MrAlvin/RAMPS-1.4.4/Schematics/RAMPS-1.4.4-C-pins.jpg

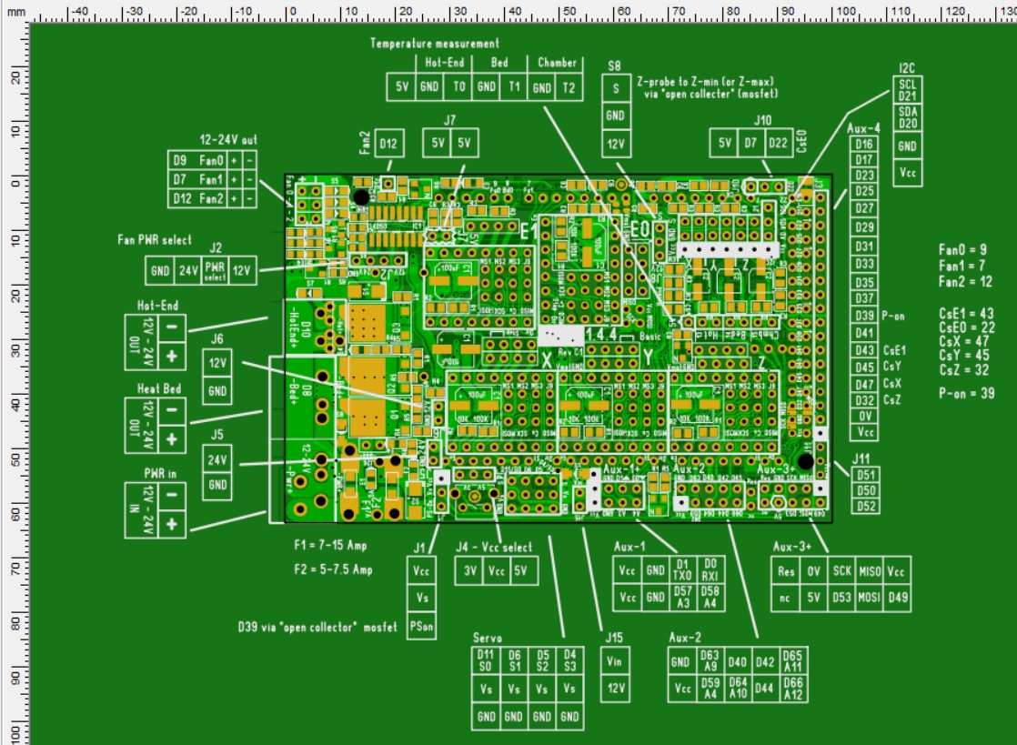
Schematics/RAMPS-1.4.4-C-pins.jpg
