MrAlvin/RAMPS-1.4.4/README.md

# RAMPS_1.4.4
An Arduino Shield for 3D printers

Documentation at: https://reprap.org/wiki/RAMPS_1.4.4<br>
Forum discussion at: todo<br>
Firmware development at: todo
