MrAlvin/RAMPS-1.4.4/Schematics/RAMPS_1.4.4-schematic-color.pdf

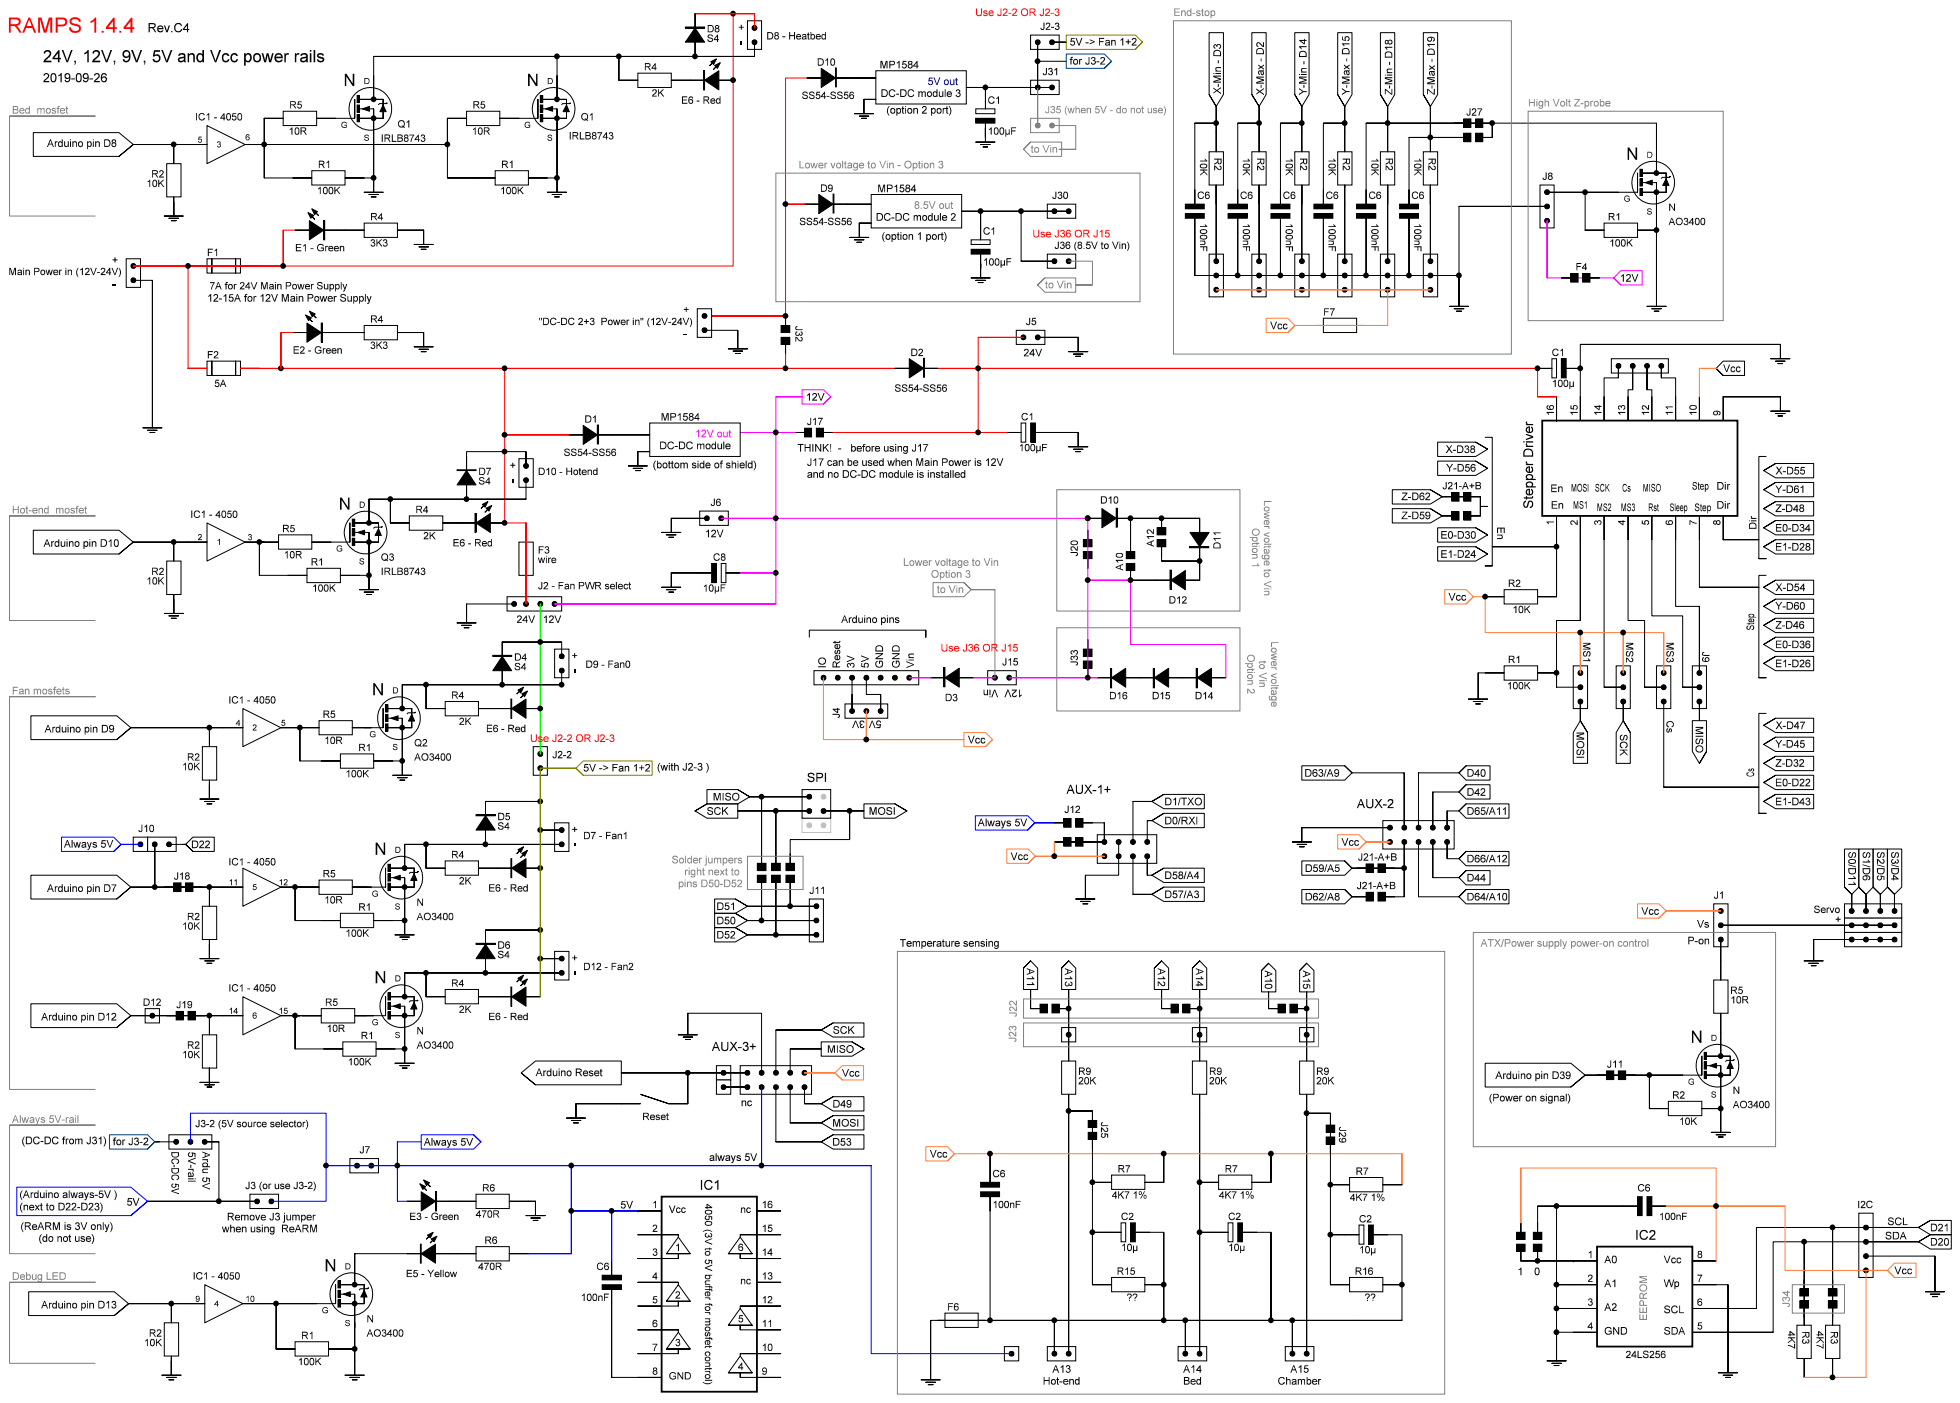
[picture p3: page 1]
