MrAlvin/RAMPS-1.4.4/(commit log)

2019-03-05 added schematics
2019-09-05 Measuring electric path resistance, and locating heat creation
2019-09-05 Illustration of Jumpers and Pins location on the PCBadded
2019-09-26 Getting ready for Revision C4 and the AGCM4 controller board
